jacky4566/ZN6_UAEFI_Adapter/FOME-libraries-main/3D_Models/VNLD5090-E.step

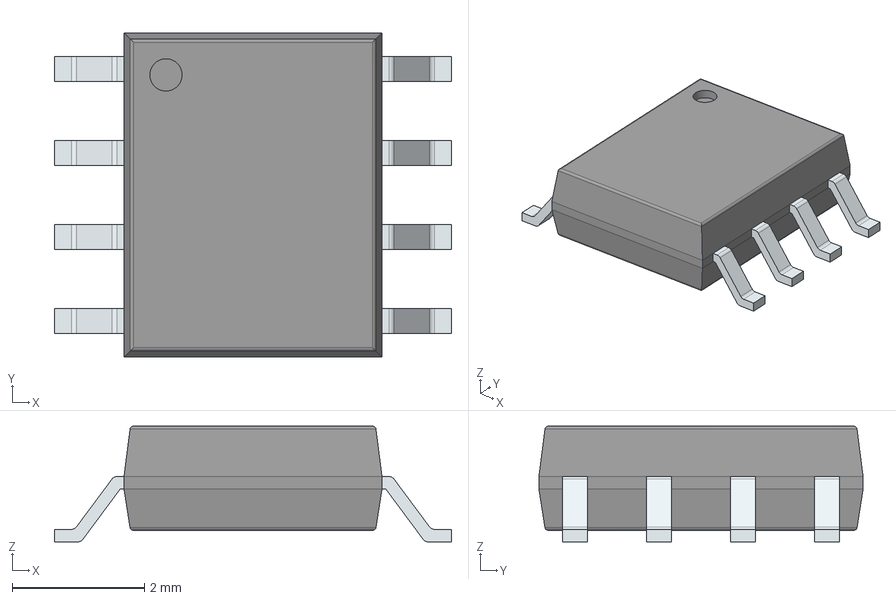
[picture p2: CAD file, 2026-10-27]
FOME-libraries-main/3D_Models/VNLD5090-E.step
6.00 x 4.90 x 1.75 mm
PinsArrayLR
