jacky4566/ZN6_UAEFI_Adapter/FOME-libraries-main/3D_Models/MIC4428YMM.step

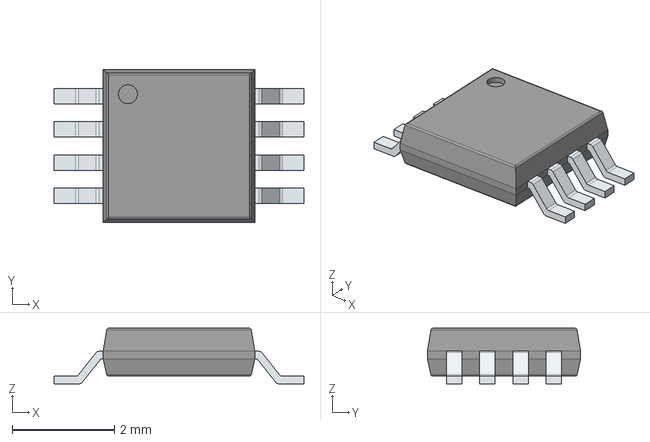
[picture p3: CAD file, 2026-10-27]
FOME-libraries-main/3D_Models/MIC4428YMM.step
4.89 x 3.00 x 1.09 mm
PinsArrayLR
