jacky4566/ZN6_UAEFI_Adapter/FOME-libraries-main/3D_Models/TE_368255-2.stp

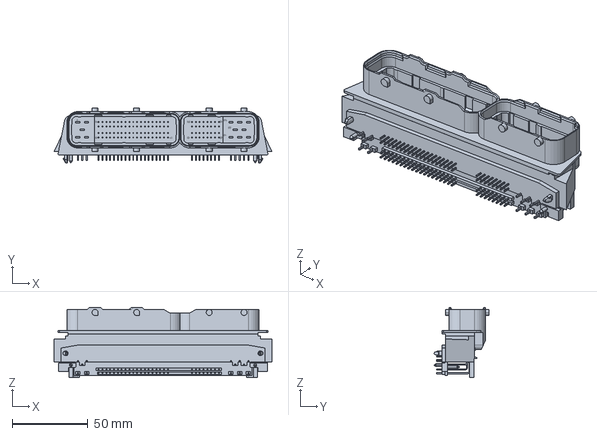
[picture p4: CAD file, 2026-10-27]
FOME-libraries-main/3D_Models/TE_368255-2.stp
144.0 x 36.2 x 46.3 mm
