jacky4566/ZN6_UAEFI_Adapter/FOME-libraries-main/3D_Models/MAX9926UAEE_V+.step

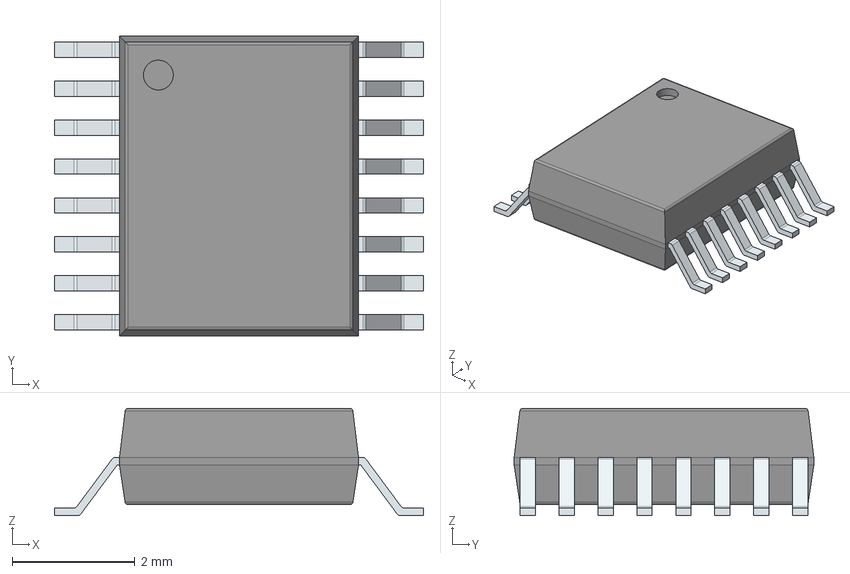
[picture p5: CAD file, 2026-10-27]
FOME-libraries-main/3D_Models/MAX9926UAEE_V+.step
6.02 x 4.89 x 1.75 mm
PinsArrayLR
