jacky4566/ZN6_UAEFI_Adapter/FOME-libraries-main/3D_Models/TIP42C.step

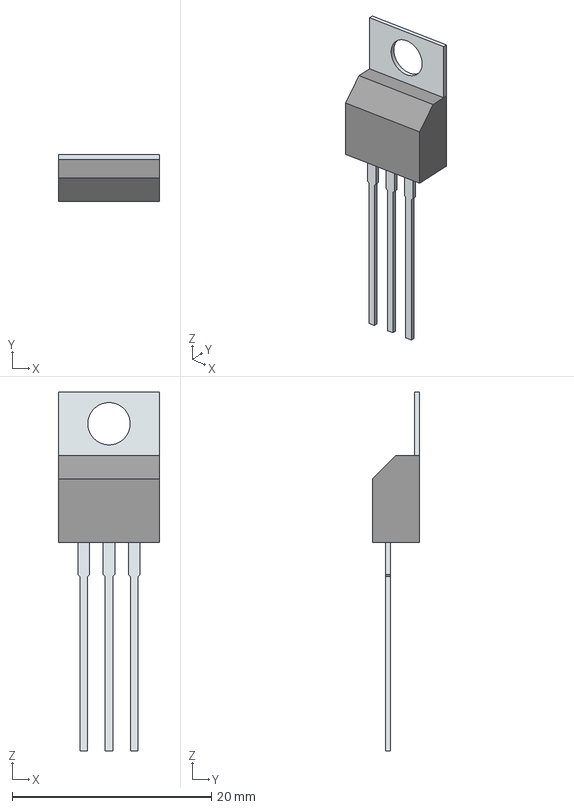
[picture p6: CAD file, 2026-10-27]
FOME-libraries-main/3D_Models/TIP42C.step
10.2 x 4.70 x 36.1 mm
Tab
PinsArray
