jacky4566/ZN6_UAEFI_Adapter/FOME-libraries-main/3D_Models/PSM712-LF-T7.step

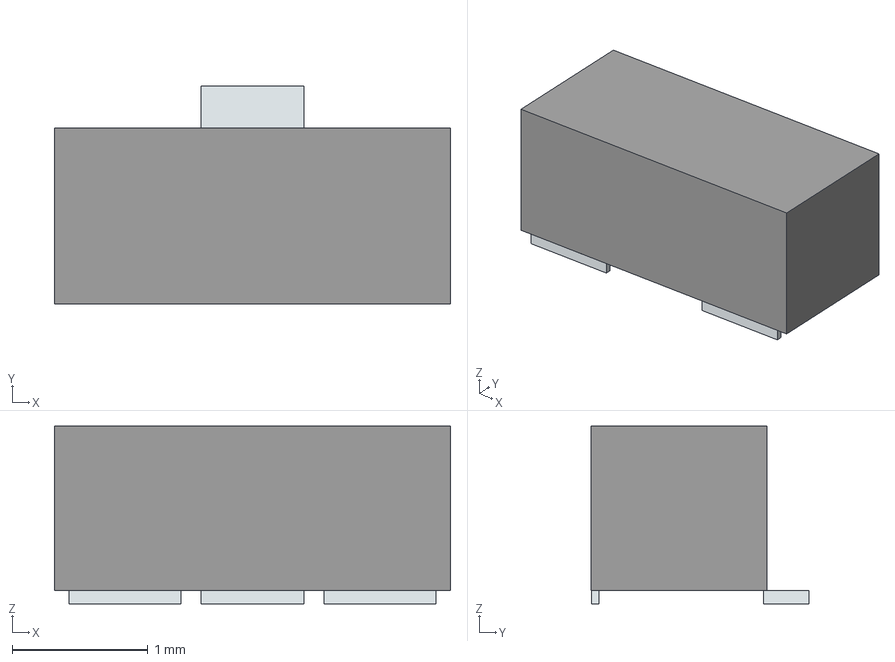
[picture p7: CAD file, 2026-10-27]
FOME-libraries-main/3D_Models/PSM712-LF-T7.step
2.92 x 1.61 x 1.31 mm
Pins
