jacky4566/ZN6_UAEFI_Adapter/FOME-libraries-main/3D_Models/PN2222A.step

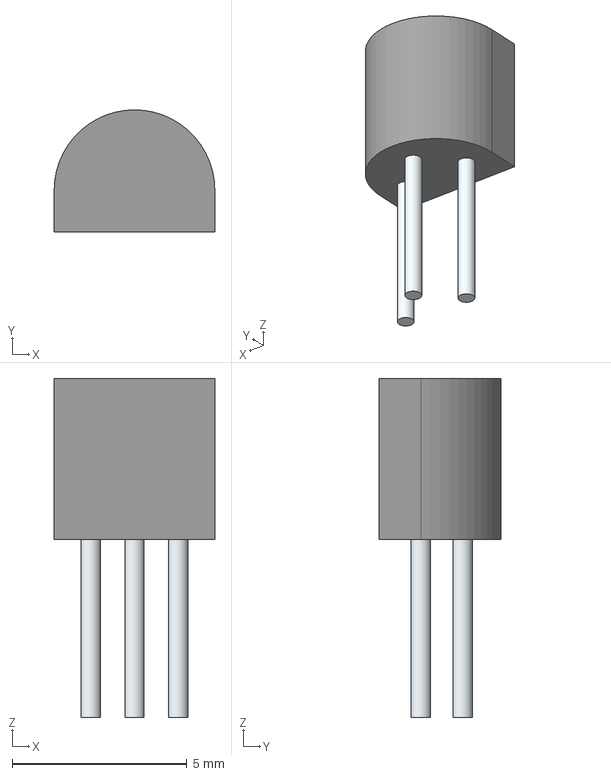
[picture p8: CAD file, 2026-10-27]
FOME-libraries-main/3D_Models/PN2222A.step
4.60 x 3.50 x 9.70 mm
Leads
