jacky4566/ZN6_UAEFI_Adapter/FOME-libraries-main/3D_Models/IRFR5305TRLPBF.step

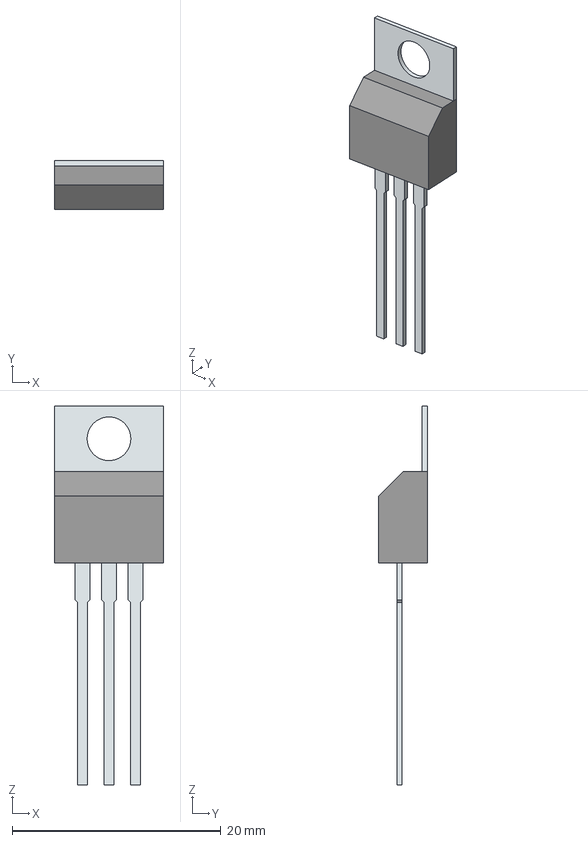
[picture p9: CAD file, 2026-10-27]
FOME-libraries-main/3D_Models/IRFR5305TRLPBF.step
10.4 x 4.69 x 36.4 mm
Tab
PinsArray
