jacky4566/ZN6_UAEFI_Adapter/FOME-libraries-main/3D_Models/IRF5305PBF.step

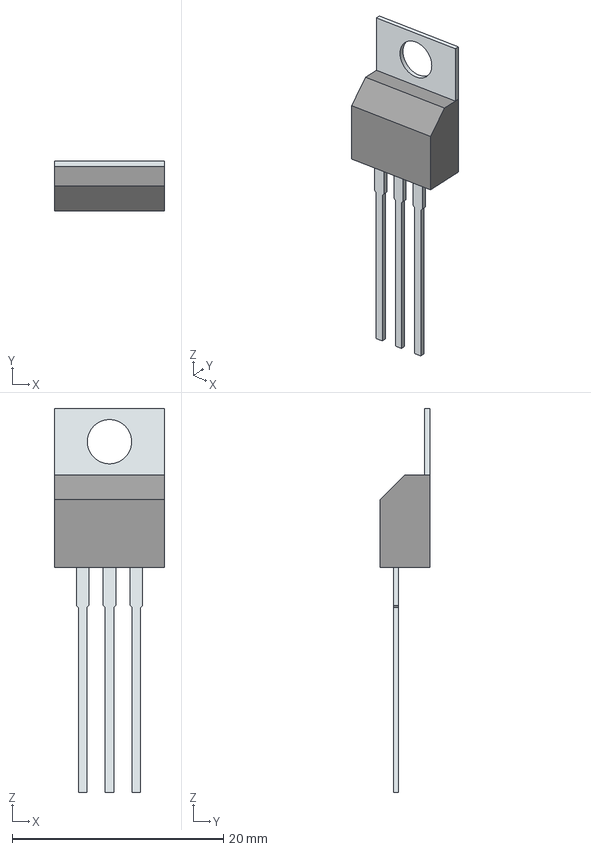
[picture p10: CAD file, 2026-10-27]
FOME-libraries-main/3D_Models/IRF5305PBF.step
10.4 x 4.69 x 36.4 mm
Tab
PinsArray
