jacky4566/ZN6_UAEFI_Adapter/FOME-libraries-main/3D_Models/NE555DR.step

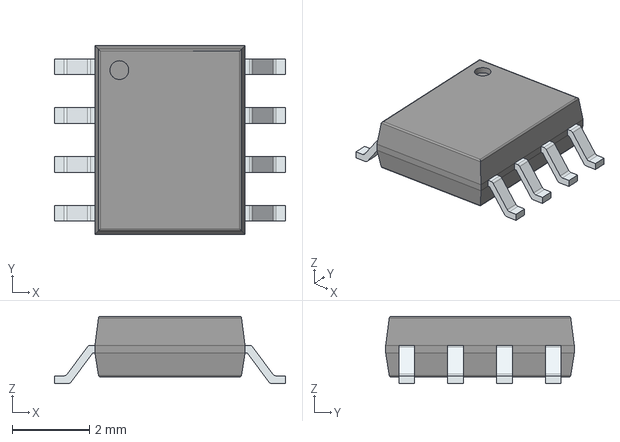
[picture p11: CAD file, 2026-10-27]
FOME-libraries-main/3D_Models/NE555DR.step
6.00 x 4.90 x 1.75 mm
PinsArrayLR
