jacky4566/ZN6_UAEFI_Adapter/FOME-libraries-main/3D_Models/2N6044.step

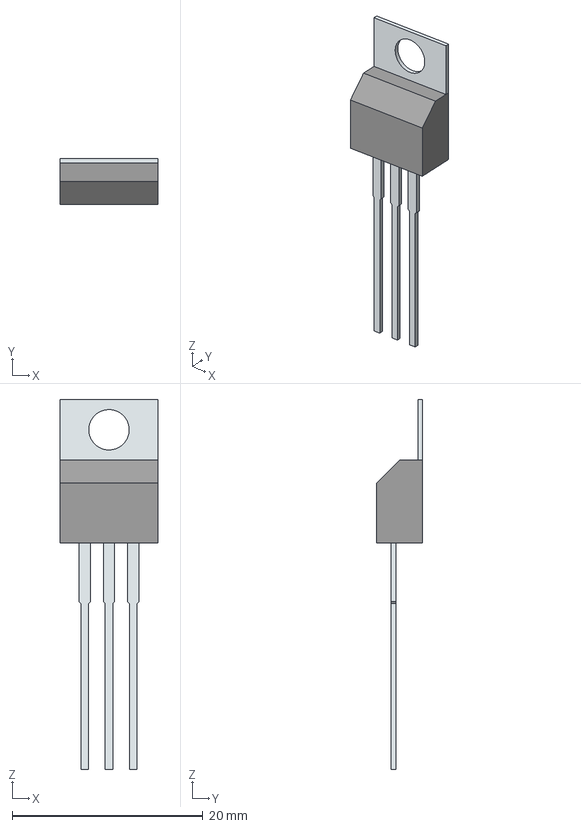
[picture p12: CAD file, 2026-10-27]
FOME-libraries-main/3D_Models/2N6044.step
10.3 x 4.82 x 38.8 mm
Tab
PinsArray
