jacky4566/ZN6_UAEFI_Adapter/FOME-libraries-main/3D_Models/BTS716GB.step

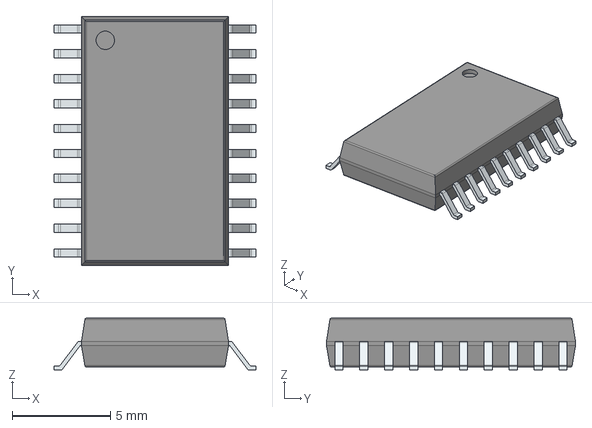
[picture p13: CAD file, 2026-10-27]
FOME-libraries-main/3D_Models/BTS716GB.step
10.3 x 12.7 x 2.65 mm
PinsArrayLR
