jacky4566/ZN6_UAEFI_Adapter/6376430-2/6376430-2.step

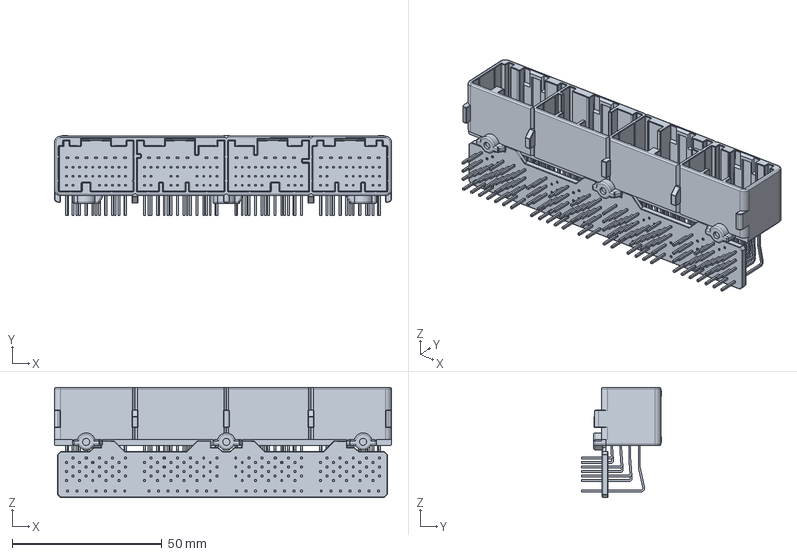
[picture p14: CAD file, 2026-10-14]
6376430-2/6376430-2.step
112.7 x 26.7 x 36.9 mm
