jacky4566/ZN6_UAEFI_Adapter/FOME-libraries-main/3D_Models/430452412.step

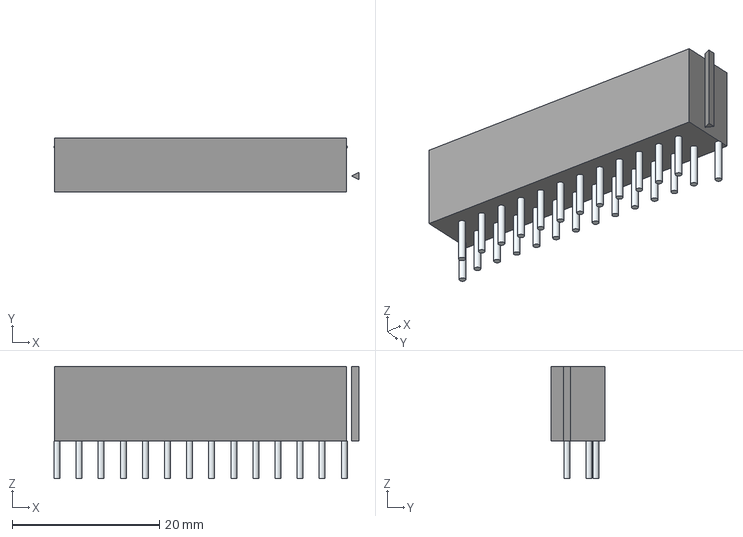
[picture p15: CAD file, 2026-10-27]
FOME-libraries-main/3D_Models/430452412.step
41.4 x 7.37 x 15.3 mm
Leads
