jacky4566/ZN6_UAEFI_Adapter/FOME-libraries-main/3D_Models/39291088.step

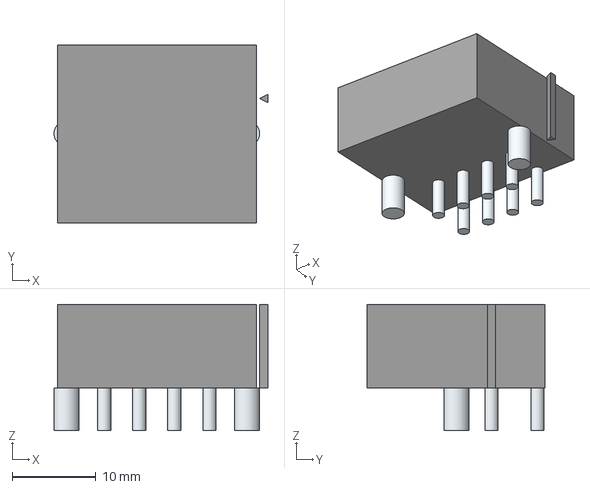
[picture p16: CAD file, 2026-10-27]
FOME-libraries-main/3D_Models/39291088.step
25.6 x 21.3 x 15.1 mm
Leads
