jacky4566/ZN6_UAEFI_Adapter/FOME-libraries-main/3D_Models/430452429.step

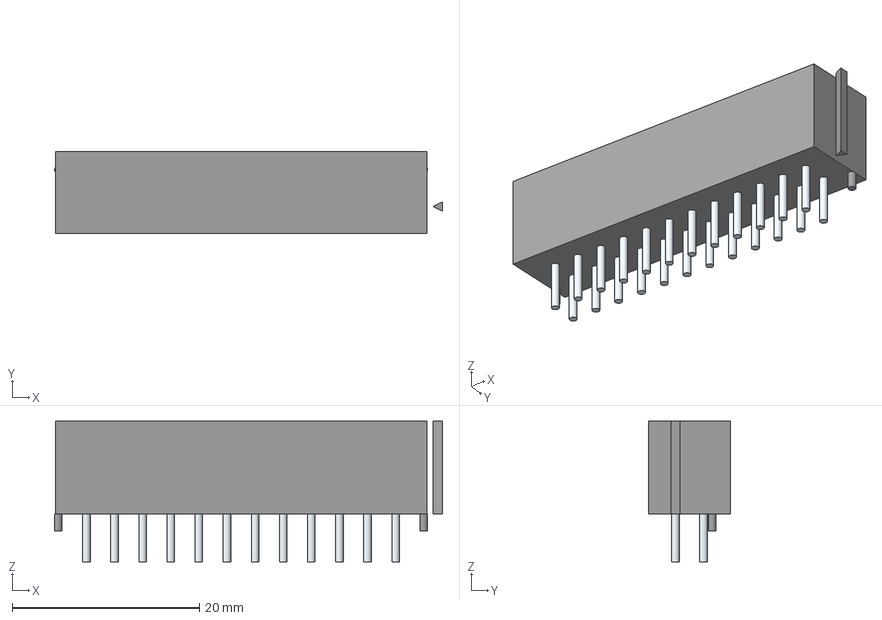
[picture p17: CAD file, 2026-10-27]
FOME-libraries-main/3D_Models/430452429.step
41.4 x 8.77 x 15.0 mm
Lugs
Leads
