jacky4566/ZN6_UAEFI_Adapter/FOME-libraries-main/3D_Models/39281203.step

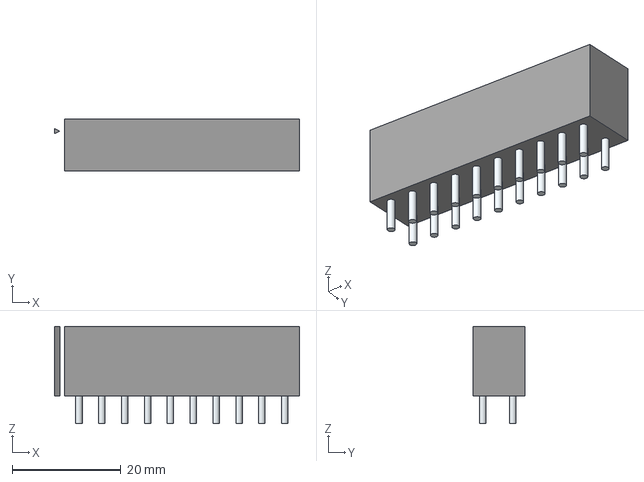
[picture p18: CAD file, 2026-10-27]
FOME-libraries-main/3D_Models/39281203.step
45.0 x 9.60 x 17.9 mm
Leads
