jacky4566/ZN6_UAEFI_Adapter/FOME-libraries-main/3D_Models/430452000.step

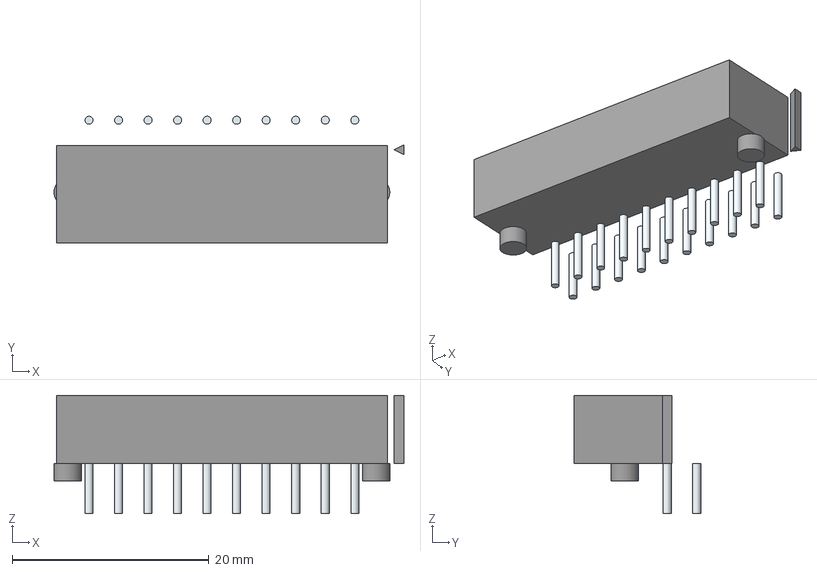
[picture p19: CAD file, 2026-10-27]
FOME-libraries-main/3D_Models/430452000.step
35.6 x 12.9 x 12.0 mm
Lugs
Leads
