jacky4566/ZN6_UAEFI_Adapter/ZN6_ATLAS_Adapter.kicad_pcb

## KiCad design ZN6_ATLAS_Adapter.kicad_pcb (2026-10-28)

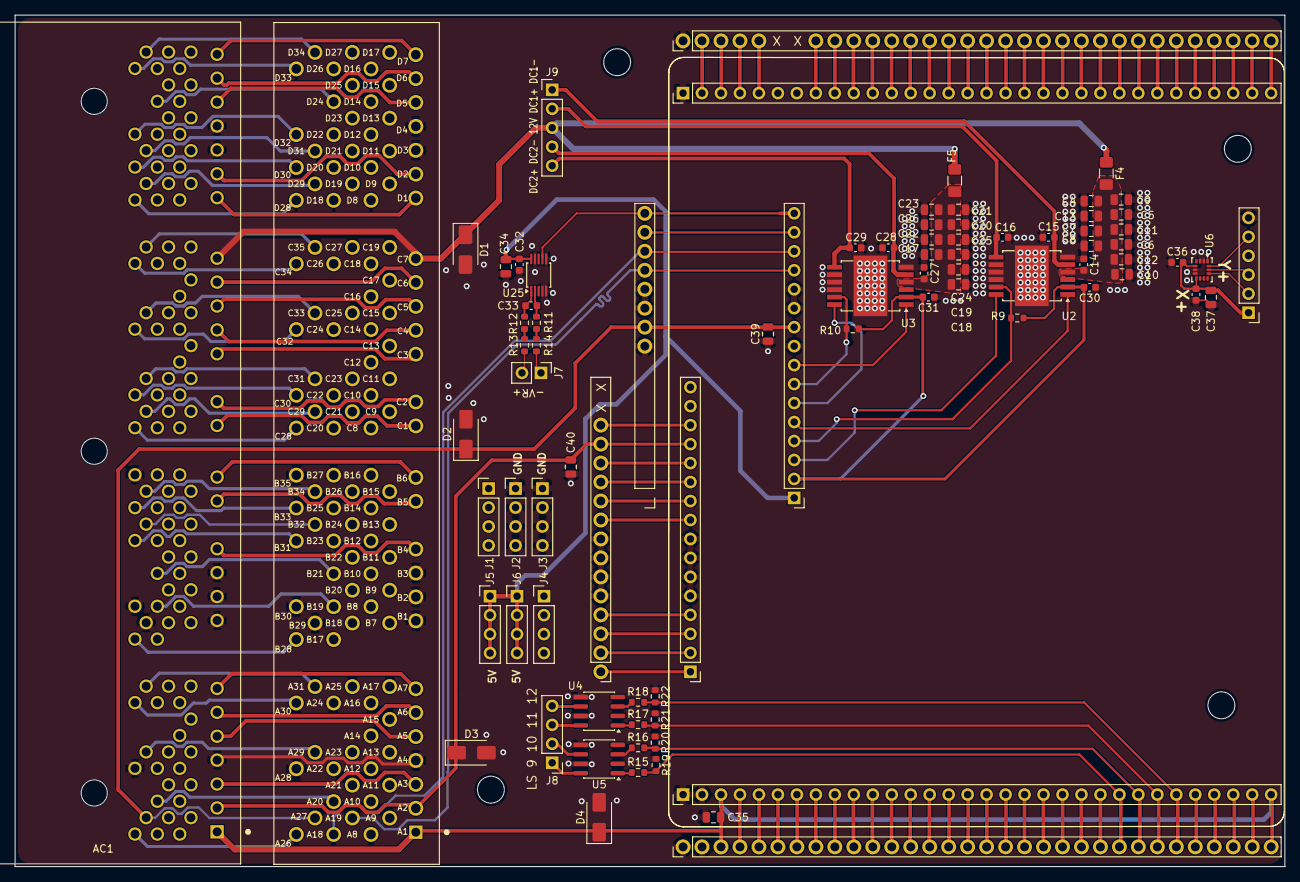
[picture p20: board ZN6_ATLAS_Adapter.kicad_pcb from above]

Board: 4 copper layers, 170.0 x 114.0 mm, 76 parts (0 on the bottom side), 228 nets.

Parts:
AC1, AC2: 6376430-2; TE_6376430-2
C4, C5, C6, C7, C8, C9, C10, C11, C12, C13, C17, C18, C19, C20, C21, C22, C23, C24, C25, C26, C34, C35, C37, C39, C40: 10u; C_0805_2012Metric
C14, C27, C30, C31, C32, C36, C38: 100n; C_0603_1608Metric
C15, C16, C28, C29: 10n; C_0603_1608Metric
C33: 1n; C_0603_1608Metric
D1, D2, D3, D4: SMAJ36A; D_SMA
F4, F5: Fuse; Fuse_1206_3216Metric_Pad1.42x1.75mm_HandSolder
J1, J2, J3, J4, J5, J6, J8: Conn_01x04_Socket; PinHeader_1x04_P2.54mm_Vertical
J7: Conn_01x02_Socket; PinHeader_1x02_P2.54mm_Vertical
J9: Conn_01x05_Pin; PinHeader_1x05_P2.54mm_Vertical
M1, M2: Polygonus ECU Module; polygonus
R9, R10, R11, R12, R13, R14, R15, R16, R17, R18, R19, R20, R21, R22: 10k; R_0603_1608Metric
U2, U3: TLE9201SG; Infineon_PG-DSO-12-11
U4, U5: VNLD5090; SOIC-8_3.9x4.9mm_P1.27mm
U6: LSM6DSV; LGA-14_3x2.5mm_P0.5mm_LayoutBorder3x4y
U25: MAX9924; TSSOP-10_3x3mm_P0.5mm

Connections:
+3.3V: C30.2, C31.2, M1.82 (3V3), R9.2, R10.2, U2.2 (VSO), U3.2 (VSO)
+5V: C32.2, C34.2, J5.1, J5.2, J5.3, J5.4, J6.1, J6.2, J6.3, J6.4, M1.81 (5V), U25.10 (VCC)
/12V_Constant: AC1.2, AC2.2, C40.2, D3.1 (K), M1.77, M2.77
/12V_MR: AC1.1, AC2.1, C35.2, D4.1 (K), M1.3 (12V_MR), M1.32 (12V_MR), M2.3 (12V_MR), M2.32 (12V_MR)
/12V_SW: AC1.27, AC2.27, C39.2, D2.1 (K), M1.90 (12V_IGN), M2.90 (12V_IGN)
/CAN1+: AC1.19, AC2.19, M1.93 (CAN+), M2.93 (CAN+)
/CAN1-: AC1.18, AC2.18, M1.94 (CAN-), M2.94 (CAN-)
/DC1_DIR: M1.85 (ETB1_DIR), U2.1 (DIR)
/DC1_DIS: M1.84 (ETB1_DIS), R9.1, U2.11 (DIS)
/DC1_PWM: M1.83 (ETB1_PWM), U2.12 (PWM)
/DC2_DIR: M1.88 (ETB2_DIR), U3.1 (DIR)
/DC2_DIS: M1.87 (ETB2_DIS), R10.1, U3.11 (DIS)
/DC2_PWM: M1.86 (ETB2_PWM), U3.12 (PWM)
/DC Driver 1/PWR: C4.2, C5.2, C6.2, C7.2, C8.2, C9.2, C10.2, C11.2, C12.2, C13.2, C14.2, F4.2, U2.4 (VS)
/DC Driver 2/PWR: C17.2, C18.2, C19.2, C20.2, C21.2, C22.2, C23.2, C24.2, C25.2, C26.2, C27.2, F5.2, U3.4 (VS)
/ETCS: AC1.73, AC2.73, D1.1 (K), F4.1, F5.1, J9.3
/IGN10: M1.14 (IGN10), M2.14 (IGN10)
/IGN11: M1.13 (IGN11), M2.13 (IGN11)
/IGN12: M1.12 (IGN12), M2.12 (IGN12)
/KNOCK1: M1.63 (Knock_1), M2.63 (Knock_1)
/KNOCK2: M1.64 (Knock_2), M2.64 (Knock_2)
/LS1: M1.4 (LS1), M2.4 (LS1)
/LS2: M1.5 (LS2), M2.5 (LS2)
/LS3: M1.6 (LS3), M2.6 (LS3)
/LS4: M1.7 (LS4), M2.7 (LS4)
/LS5: M1.8 (LS5), M2.8 (LS5)
/LS6: M1.9 (LS6), M2.9 (LS6)
/LS7: M1.10 (LS7), M2.10 (LS7)
/LS8: M1.11 (LS8), M2.11 (LS8)
/LS9: M1.24, M2.24, R15.2, R19.1
/LS10: M1.25, M2.25, R16.2, R20.1
/LS11: M1.26, M2.26, R17.2, R21.1
/LS12: M1.27, M2.27, R18.2, R22.1
/MAX9924+: J7.2, R13.2
/MAX9924-: J7.1, R14.2
/OUT_DC1+: C16.2, J9.2, U2.7 (OUT2)
/OUT_DC1-: C15.2, J9.1, U2.5 (OUT1)
/OUT_DC2+: C29.2, J9.5, U3.7 (OUT2)
/OUT_DC2-: C28.2, J9.4, U3.5 (OUT1)
/RC1: M1.75 (RC1), M2.75 (RC1)
/RC2: M1.76 (RC2), M2.76 (RC2)
/SPI_3V3: C36.2, C37.2, C38.2, M1.102, U6.5 (VDDIO), U6.8 (VDD)
/SPI_CS: M1.103, U6.12 (CS)
/SPI_MISO: M1.105, U6.1 (SDO/SA0)
/SPI_MOSI: M1.106, U6.14 (SDA)
/SPI_SCK: M1.104, U6.13 (SCL)
/VR1: M1.96 (VR1), M2.96 (VR1), U25.7 (COUT)
/VR2: M1.95 (VR2), M2.95 (VR2)
GND: AC1.28, AC1.32, AC1.33, AC1.34, AC1.60, AC1.61, AC1.66, AC1.104, AC1.105, AC2.28, AC2.32, AC2.33, AC2.34, AC2.60, AC2.61, AC2.66, AC2.104, AC2.105, C4.1, C5.1, C6.1, C7.1, C8.1, C9.1, C10.1, C11.1, C12.1, C13.1, C14.1, C15.1, C16.1, C17.1, C18.1, C19.1, C20.1, C21.1, C22.1, C23.1, C24.1, C25.1, C26.1, C27.1, C28.1, C29.1, C30.1, C31.1, C32.1, C34.1, C35.1, C36.1, C37.1, C38.1, C39.1, C40.1, D1.2 (A), D2.2 (A), D3.2 (A), D4.2 (A), J2.1, J2.2, J2.3, J2.4, J3.1, J3.2, J3.3, J3.4, M1.1 (GND), M1.2 (GND), M1.33 (GND), M1.69 (GND), M1.70 (GND), M1.71 (GND), M1.72 (GND), M1.89 (GND), M1.91 (GND), M1.92 (GND), M1.107, M2.1 (GND), M2.2 (GND), M2.33 (GND), M2.69 (GND), M2.70 (GND), M2.71 (GND), M2.72 (GND), M2.89 (GND), M2.91 (GND), M2.92 (GND), R19.2, R20.2, R21.2, R22.2, U2.6 (GND), U2.8 (SI), U2.9 (CSN), U2.10 (SCK), U2.13 (GND), U3.6 (GND), U3.8 (SI), U3.9 (CSN), U3.10 (SCK), U3.13 (GND), U4.5 (S2), U4.7 (S1), U5.5 (S2), U5.7 (S1), U6.2 (SDX), U6.3 (SCX), U6.6 (GND), U6.7 (GND), U25.4 (BIAS), U25.5 (GND), U25.6 (ZERO_EN), U25.9 (INT_THRS)
unnamed: AC1.3, AC2.3
unnamed: AC1.4, AC2.4
unnamed: AC1.5, AC2.5
unnamed: AC1.6, AC2.6
unnamed: AC1.7, AC2.7
unnamed: AC1.8, AC2.8
unnamed: AC1.9, AC2.9
unnamed: AC1.10, AC2.10
unnamed: AC1.11, AC2.11
unnamed: AC1.12, AC2.12
unnamed: AC1.13, AC2.13
unnamed: AC1.14, AC2.14
unnamed: AC1.15, AC2.15
unnamed: AC1.16, AC2.16
unnamed: AC1.17, AC2.17
unnamed: AC1.20, AC2.20
unnamed: AC1.21, AC2.21
unnamed: AC1.22, AC2.22
unnamed: AC1.23, AC2.23
unnamed: AC1.24, AC2.24
unnamed: AC1.25, AC2.25
unnamed: AC1.26, AC2.26
unnamed: AC1.29, AC2.29
unnamed: AC1.30, AC2.30
unnamed: AC1.31, AC2.31
unnamed: AC1.35, AC2.35
unnamed: AC1.36, AC2.36
unnamed: AC1.37, AC2.37
unnamed: AC1.38, AC2.38
unnamed: AC1.39, AC2.39
unnamed: AC1.40, AC2.40
unnamed: AC1.41, AC2.41
unnamed: AC1.42, AC2.42
unnamed: AC1.43, AC2.43
unnamed: AC1.44, AC2.44
unnamed: AC1.45, AC2.45
unnamed: AC1.46, AC2.46
unnamed: AC1.47, AC2.47
unnamed: AC1.48, AC2.48
unnamed: AC1.49, AC2.49
unnamed: AC1.50, AC2.50
unnamed: AC1.51, AC2.51
unnamed: AC1.52, AC2.52
unnamed: AC1.53, AC2.53
unnamed: AC1.54, AC2.54
unnamed: AC1.55, AC2.55
unnamed: AC1.56, AC2.56
unnamed: AC1.57, AC2.57
unnamed: AC1.58, AC2.58
unnamed: AC1.59, AC2.59
unnamed: AC1.62, AC2.62
unnamed: AC1.63, AC2.63
unnamed: AC1.64, AC2.64
unnamed: AC1.65, AC2.65
unnamed: AC1.67, AC2.67
unnamed: AC1.68, AC2.68
unnamed: AC1.69, AC2.69
unnamed: AC1.70, AC2.70
unnamed: AC1.71, AC2.71
unnamed: AC1.72, AC2.72
unnamed: AC1.74, AC2.74
unnamed: AC1.75, AC2.75
unnamed: AC1.76, AC2.76
unnamed: AC1.77, AC2.77
unnamed: AC1.78, AC2.78
unnamed: AC1.79, AC2.79
unnamed: AC1.80, AC2.80
unnamed: AC1.81, AC2.81
unnamed: AC1.82, AC2.82
unnamed: AC1.83, AC2.83
unnamed: AC1.84, AC2.84
unnamed: AC1.85, AC2.85
unnamed: AC1.86, AC2.86
unnamed: AC1.87, AC2.87
unnamed: AC1.88, AC2.88
unnamed: AC1.89, AC2.89
unnamed: AC1.90, AC2.90
unnamed: AC1.91, AC2.91
unnamed: AC1.92, AC2.92
unnamed: AC1.93, AC2.93
unnamed: AC1.94, AC2.94
unnamed: AC1.95, AC2.95
unnamed: AC1.96, AC2.96
unnamed: AC1.97, AC2.97
unnamed: AC1.98, AC2.98
unnamed: AC1.99, AC2.99
unnamed: AC1.100, AC2.100
unnamed: AC1.101, AC2.101
unnamed: AC1.102, AC2.102
unnamed: AC1.103, AC2.103
unnamed: AC1.106, AC2.106
unnamed: AC1.107, AC2.107
unnamed: AC1.108, AC2.108
unnamed: AC1.109, AC2.109
unnamed: AC1.110, AC2.110
unnamed: AC1.111, AC2.111
unnamed: AC1.112, AC2.112
unnamed: AC1.113, AC2.113
unnamed: AC1.114, AC2.114
unnamed: AC1.115, AC2.115
unnamed: AC1.116, AC2.116
unnamed: AC1.117, AC2.117
unnamed: AC1.118, AC2.118
unnamed: AC1.119, AC2.119
unnamed: AC1.120, AC2.120
unnamed: AC1.121, AC2.121
unnamed: AC1.122, AC2.122
unnamed: AC1.123, AC2.123
unnamed: AC1.124, AC2.124
unnamed: AC1.125, AC2.125
unnamed: AC1.126, AC2.126
unnamed: AC1.127, AC2.127
unnamed: AC1.128, AC2.128
unnamed: AC1.129, AC2.129
unnamed: AC1.130, AC2.130
unnamed: AC1.131, AC2.131
unnamed: AC1.132, AC2.132
unnamed: AC1.133, AC2.133
unnamed: AC1.134, AC2.134
unnamed: AC1.135, AC2.135
unnamed: J8.1, U5.8 (D1)
unnamed: J8.2, U5.6 (D2)
unnamed: J8.3, U4.8 (D1)
unnamed: J8.4, U4.6 (D2)
unnamed: M1.40 (5V_SENSOR_1), M2.40 (5V_SENSOR_1)
unnamed: M1.41 (5V_SENSOR_1), M2.41 (5V_SENSOR_1)
unnamed: M1.36 (5V_SENSOR_2), M2.36 (5V_SENSOR_2)
unnamed: M1.37 (5V_SENSOR_2), M2.37 (5V_SENSOR_2)
unnamed: M1.73 (CAN2+), M2.73 (CAN2+)
unnamed: M1.74 (CAN2-), M2.74 (CAN2-)
unnamed: M1.15, M2.15
unnamed: M1.16, M2.16
unnamed: M1.17, M2.17
unnamed: M1.18, M2.18
unnamed: M1.19, M2.19
unnamed: M1.20, M2.20
unnamed: M1.21, M2.21
unnamed: M1.22, M2.22
unnamed: M1.23, M2.23
unnamed: M1.28, M2.28
unnamed: M1.29, M2.29
unnamed: M1.30, M2.30
unnamed: M1.31, M2.31
unnamed: M1.34, M2.34
unnamed: M1.35, M2.35
unnamed: M1.42, M2.42
unnamed: M1.43, M2.43
unnamed: M1.44, M2.44
unnamed: M1.45, M2.45
unnamed: M1.46, M2.46
unnamed: M1.47, M2.47
unnamed: M1.48, M2.48
unnamed: M1.49, M2.49
unnamed: M1.50, M2.50
unnamed: M1.51, M2.51
unnamed: M1.52, M2.52
unnamed: M1.53, M2.53
unnamed: M1.54, M2.54
unnamed: M1.55, M2.55
unnamed: M1.56, M2.56
unnamed: M1.57, M2.57
unnamed: M1.58, M2.58
unnamed: M1.59, M2.59
unnamed: M1.60, M2.60
unnamed: M1.61, M2.61
unnamed: M1.62, M2.62
unnamed: M1.65, M2.65
unnamed: M1.66, M2.66
unnamed: M1.67, M2.67
unnamed: M1.68, M2.68
unnamed: M1.78, M2.78
unnamed: R11.2, R14.1
unnamed: R12.2, R13.1
unnamed: R17.1, U4.1 (IN1)
unnamed: R18.1, U4.3 (IN2)
unnamed: R15.1, U5.1 (IN1)
unnamed: R16.1, U5.3 (IN2)
unnamed: C33.1, R12.1, U25.1 (IN+)
unnamed: C33.2, R11.1, U25.2 (IN-)
