jacky4566/ZN6_UAEFI_Adapter/(commit log)

2026-10-14 First Draft
    RUSEFI board for ZN6 platform fitted with EZ36 engine
    [6376430-2.step, ZN6_UAEFI_Adapter.kicad_pcb, ZN6_UAEFI_Adapter.kicad_sch]
2026-10-14 More Tweaks!
    [ZN6_UAEFI_Adapter.kicad_pcb, ZN6_UAEFI_Adapter.kicad_sch]
2026-10-15 First Draft of Adapter board
    [ADS712.kicad_sch, ADS7128IRTER.step, Wiring.xlsx, ZN6_UAEFI_Adapter.kicad_pcb, ZN6_UAEFI_Adapter.kicad_sch]
2026-10-15 Add ZN6 uaEFI adapter README
    This change introduces the initial README for the ZN6 uaEFI adapter project. It documents the board purpose, pin mapping, fixed connections, RTC and expander features, open questions, repository structure, and references for the DIY adapter.
2026-10-19 Add some things
    [ZN6_THR_Adapter.kicad_pcb, ZN6_UAEFI_Adapter.kicad_pcb]
2026-10-19 Re-adjust project for uaEFI instead.
    [ADS712.kicad_sch, ADS7128IRTER.step, ZN6_THR_Adapter.kicad_pcb, ZN6_UAEFI_Adapter.kicad_pcb, ZN6_UAEFI_Adapter.kicad_sch]
2026-10-19 Update Image
    [ZN6_UAEFI_Adapter.kicad_pcb]
2026-10-27 First Publish
    [2N6044.step, 39281203.step, 39291088.step, 430452000.step, 430452412.step, 430452429.step, BTS716GB.step, DC_MOTOR_0.1.kicad_sch]
2026-10-27 Update README for ATLAS adapter
    Rename the project documentation from uaEFI to ATLAS, add the board render and summarize its onboard circuits, wiring, and library references.
2026-10-28 Add TVS protection and clarify board nets
    Add SMAJ36A protection to the 12V rails and ETCS input, label adapter signal nets, update routing, and document the hard-wired ECU pins.
    [ZN6_ATLAS_Adapter.kicad_pcb, ZN6_ATLAS_Adapter.kicad_sch]
